HuyNguyen-01/Power-Management/Connector Extension Board V1.0/Connector_Extension_Board_V1.0/Connector_Extension_Board_V1.0.step

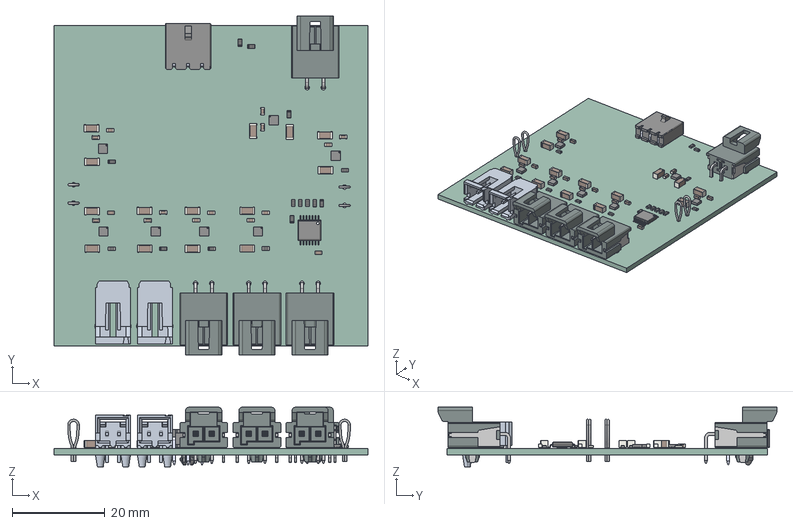
[picture p1: CAD file, 2026-01-13]
Connector Extension Board V1.0/Connector_Extension_Board_V1.0/Connector_Extension_Board_V1.0.step
67.7 x 73.0 x 12.8 mm
TestPoint_Loop_D2.50mm_Drill1.0mm x 4
TPS259571DSGR x 7
R_0603_1608Metric x 15
C_0603_1608Metric x 15
C_1206_3216Metric x 14
TPS1HC30BQPWPRQ1
Connector_Extension_Board_V1.0_PCB
