HuyNguyen-01/Power-Management/Power management V2/Power_management_V2/Power_management_V2.step

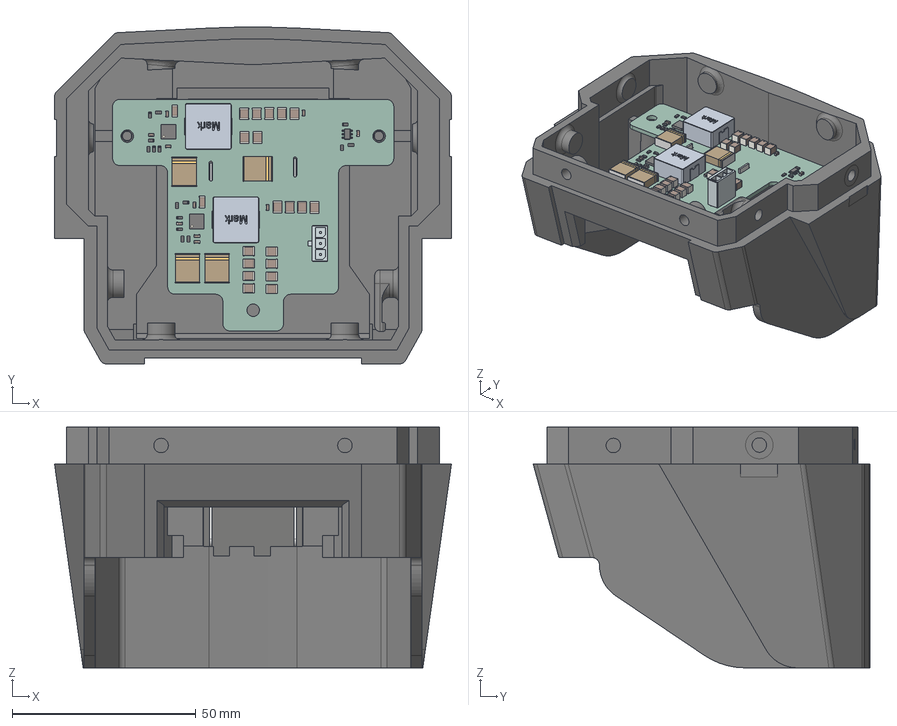
[picture p2: CAD file, 2026-01-13]
Power management V2/Power_management_V2/Power_management_V2.step
108.0 x 91.6 x 65.5 mm
C_0603_1608Metric x 10
R_0603_1608Metric x 15
C_1210_3225Metric x 19
C_1206_3216Metric x 2
SRP1265A series x 2
CAP_C7563_TDK x 4
WSON-14-1EP_4.0x4.0mm_P0.5mm_EP2.6x2.6mm x 2
TSOT-23-6
DIP-PUL-3005-1
DIP-PUL-3010-1 v1
Power_management_V2_PCB
