HuyNguyen-01/Power-Management/Power management V2/Power_management_V2/3D/Batterry.step

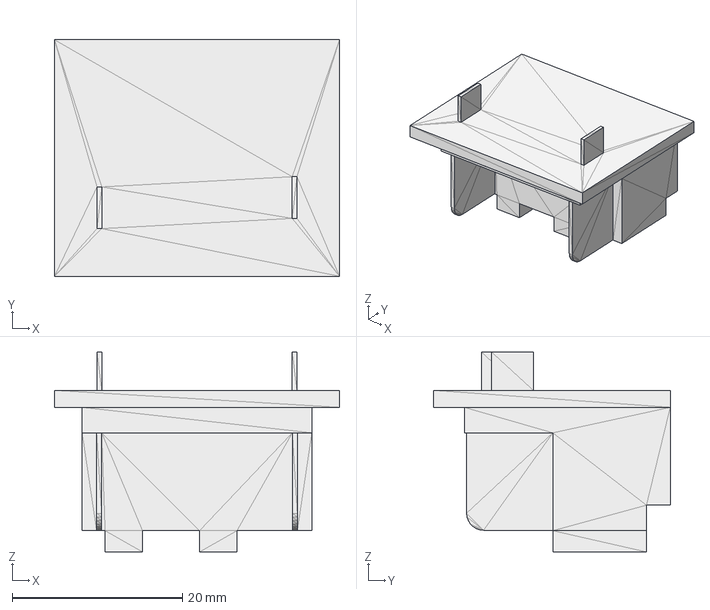
[picture p3: CAD file, 2025-12-29]
Power management V2/Power_management_V2/3D/Batterry.step
33.5 x 27.8 x 23.5 mm
