HuyNguyen-01/Power-Management/Power management V2/Power_management_V2/3D/DIP-PUL-3005-2.step

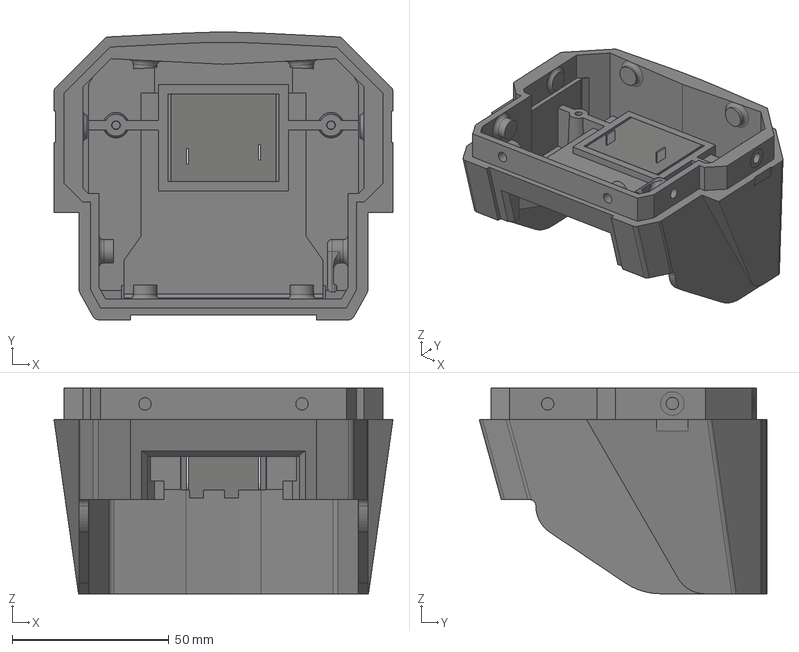
[picture p4: CAD file, 2025-12-29]
Power management V2/Power_management_V2/3D/DIP-PUL-3005-2.step
108.0 x 91.6 x 65.5 mm
DIP-PUL-3005-1
DIP-PUL-3010-1
