HuyNguyen-01/Power-Management/Connector Extension Board V1.0/Connector_Extension_Board_V1.0/3D/5-104361-1.step

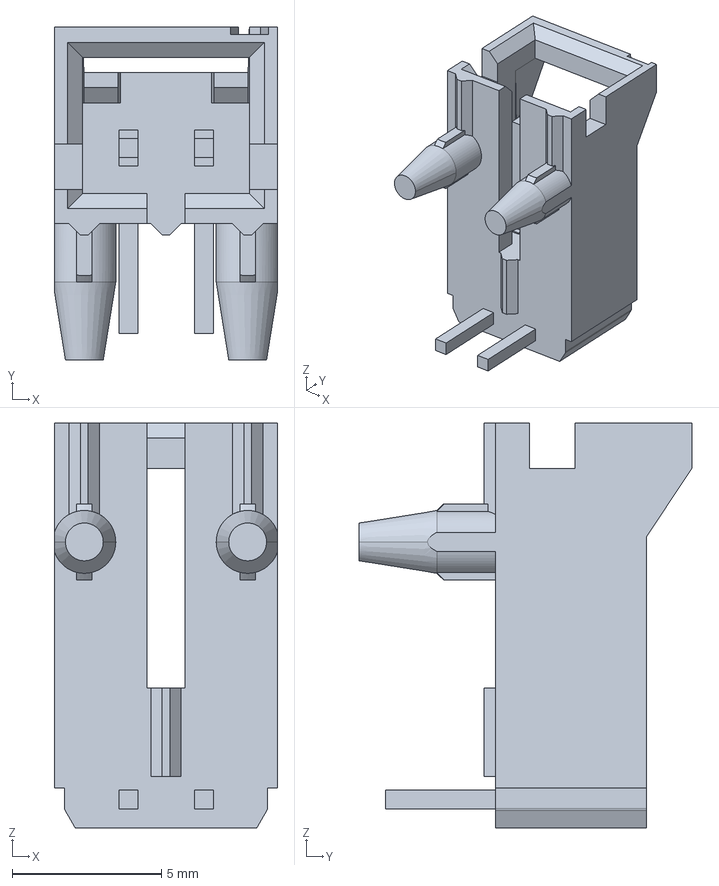
[picture p5: CAD file, 2025-12-26]
Connector Extension Board V1.0/Connector_Extension_Board_V1.0/3D/5-104361-1.step
7.49 x 11.2 x 13.6 mm
