HuyNguyen-01/Power-Management/Power management V2/Power_management_V2/3D/CAP_C7563_TDK.step

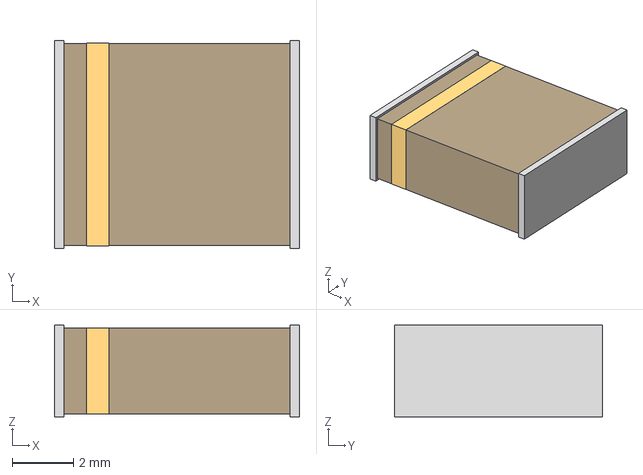
[picture p6: CAD file, 2025-12-29]
Power management V2/Power_management_V2/3D/CAP_C7563_TDK.step
8.00 x 6.81 x 3.00 mm
