HuyNguyen-01/Power-Management/Connector Extension Board V1.0/Connector_Extension_Board_V1.0/3D/TPS1HC30BQPWPRQ1.step

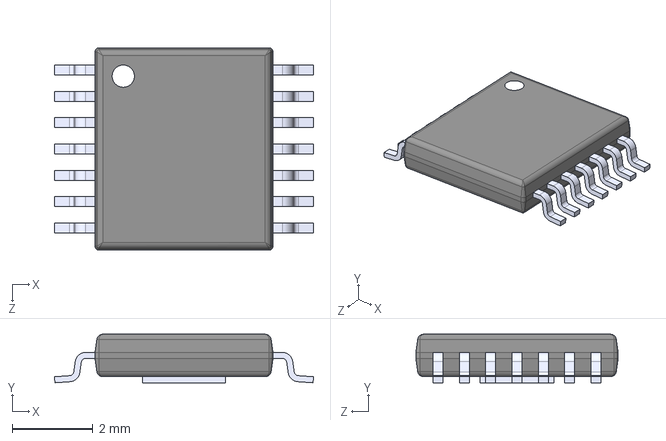
[picture p7: CAD file, 2025-12-26]
Connector Extension Board V1.0/Connector_Extension_Board_V1.0/3D/TPS1HC30BQPWPRQ1.step
6.40 x 1.20 x 5.00 mm
