HuyNguyen-01/Power-Management/Power management V2/Power_management_V2/3D/M18 Battery Terminal.step

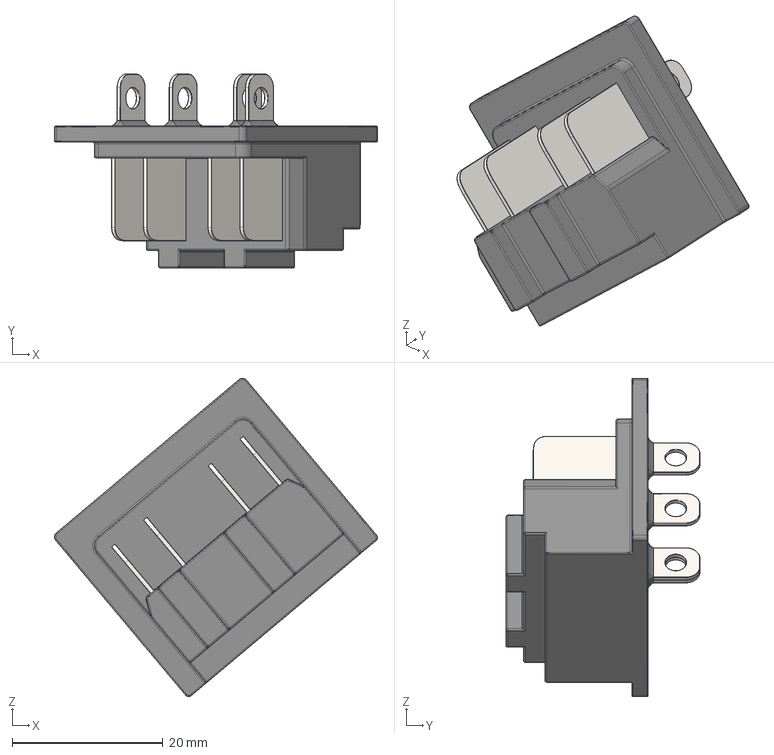
[picture p8: CAD file, 2025-12-26]
Power management V2/Power_management_V2/3D/M18 Battery Terminal.step
42.8 x 25.7 x 42.2 mm
