HuyNguyen-01/Power-Management/Power management V2/Power_management_V2/3D/SRP1265A series.stp

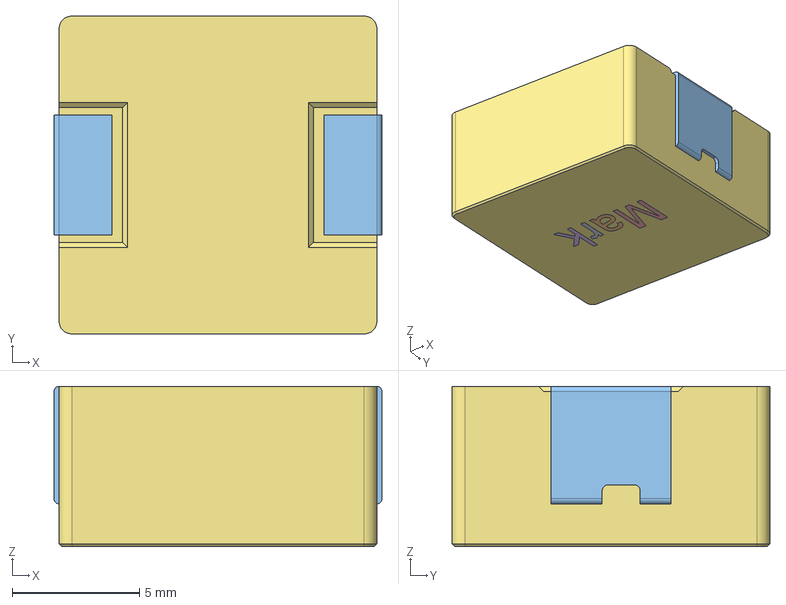
[picture p9: CAD file, 2025-12-26]
Power management V2/Power_management_V2/3D/SRP1265A series.stp
12.9 x 12.5 x 6.30 mm
