HuyNguyen-01/Power-Management/Connector Extension Board V1.0/Connector_Extension_Board_V1.0/3D/5-104809-1.step

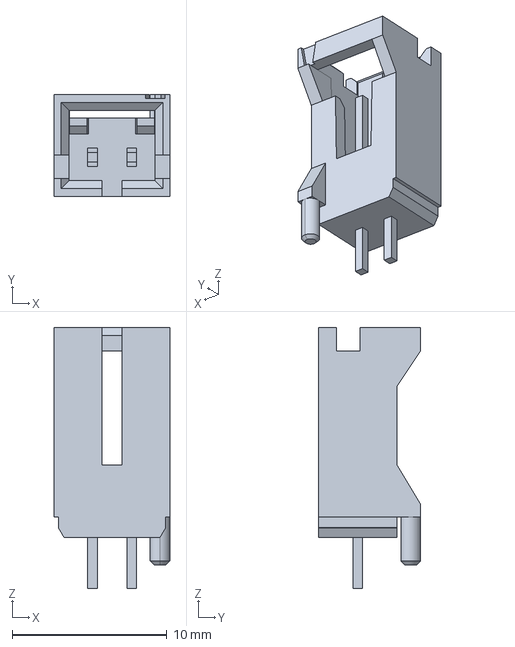
[picture p10: CAD file, 2025-12-17]
Connector Extension Board V1.0/Connector_Extension_Board_V1.0/3D/5-104809-1.step
7.49 x 6.60 x 16.9 mm
