HuyNguyen-01/Power-Management/Connector Extension Board V1.0/Connector_Extension_Board_V1.0/3D/1723103104.step

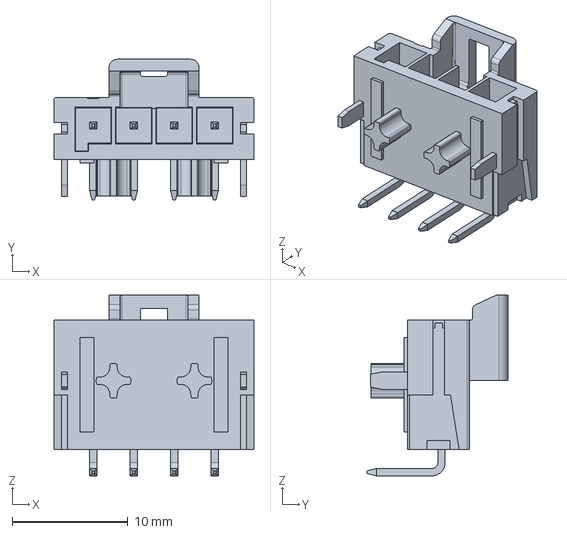
[picture p11: CAD file, 2026-02-25]
Connector Extension Board V1.0/Connector_Extension_Board_V1.0/3D/1723103104.step
17.3 x 12.2 x 15.6 mm
