HuyNguyen-01/Power-Management/Power management V2/Power_management_V2/3D/1722861104.step

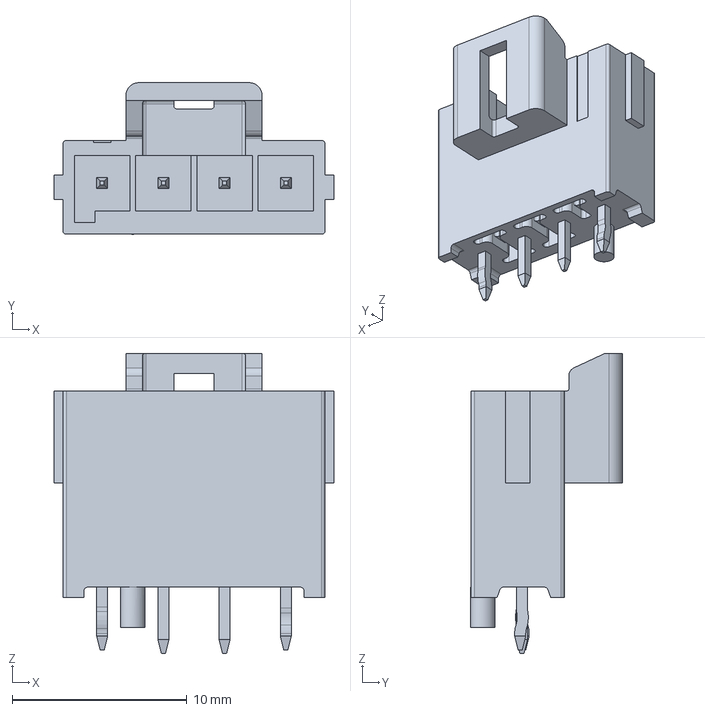
[picture p12: CAD file, 2026-02-25]
Power management V2/Power_management_V2/3D/1722861104.step
16.0 x 8.67 x 17.2 mm
