HuyNguyen-01/Power-Management/Connector Extension Board V1.0/Connector_Extension_Board_V1.0/3D/2157601004.step

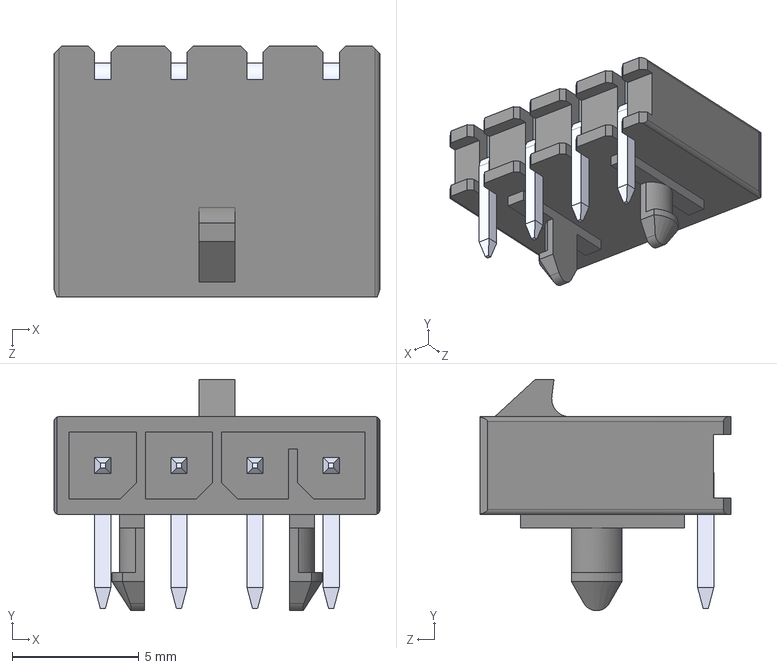
[picture p13: CAD file, 2026-02-04]
Connector Extension Board V1.0/Connector_Extension_Board_V1.0/3D/2157601004.step
12.9 x 9.12 x 9.90 mm
