HuyNguyen-01/Power-Management/Power management V2/Power_management_V2/3D/2165711004.stp

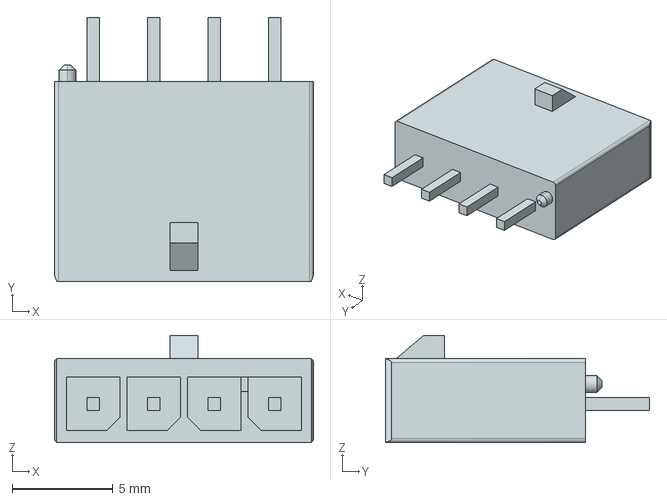
[picture p14: CAD file, 2026-02-04]
Power management V2/Power_management_V2/3D/2165711004.stp
12.8 x 13.1 x 5.33 mm
