HuyNguyen-01/Power-Management/Connector Extension Board V1.0/Connector_Extension_Board_V1.0/3D/TPS259571DSGR.step

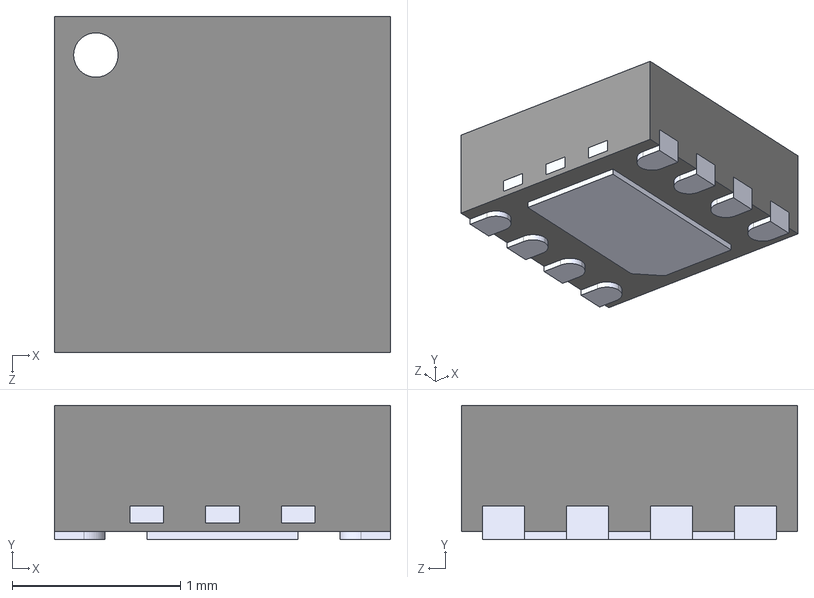
[picture p15: CAD file, 2026-01-13]
Connector Extension Board V1.0/Connector_Extension_Board_V1.0/3D/TPS259571DSGR.step
2.00 x 0.8 x 2.00 mm
