HuyNguyen-01/Power-Management/Power management V2/Power_management_V2/3D/2165711003.stp

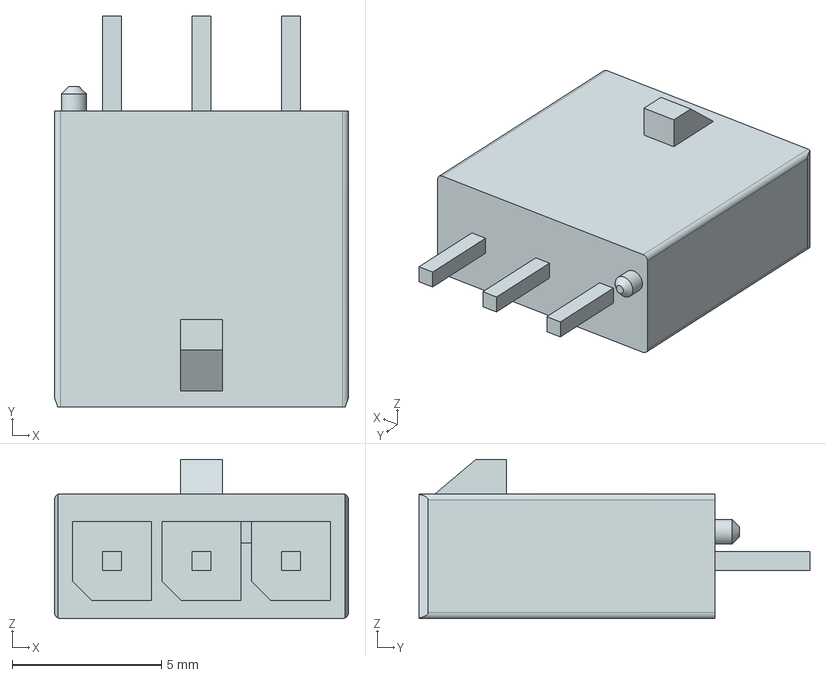
[picture p16: CAD file, 2026-01-12]
Power management V2/Power_management_V2/3D/2165711003.stp
9.85 x 13.1 x 5.33 mm
