HuyNguyen-01/Power-Management/Connector Extension Board V1.0/Connector_Extension_Board_V1.0/3D/2157601003.step

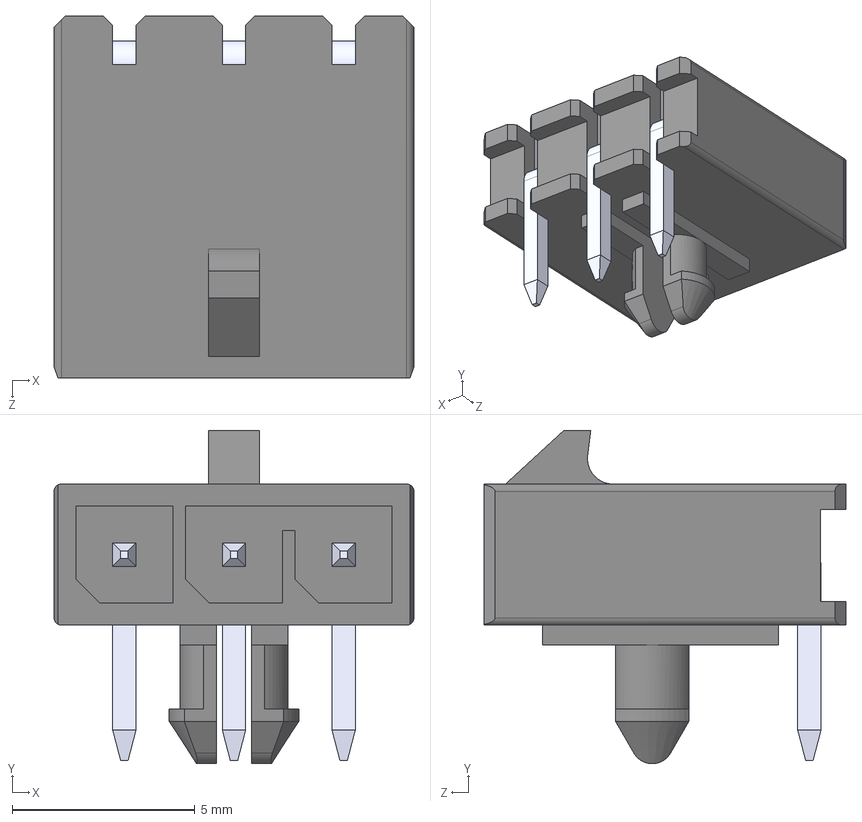
[picture p17: CAD file, 2026-01-13]
Connector Extension Board V1.0/Connector_Extension_Board_V1.0/3D/2157601003.step
9.85 x 9.12 x 9.90 mm
