HuyNguyen-01/Power-Management/(list of files, cad)

Other CAD files:
Connector Extension Board V1.0/Connector_Extension_Board_V1.0/3D/1722871102.step
Connector Extension Board V1.0/Connector_Extension_Board_V1.0/3D/1723103102.stp
Connector Extension Board V1.0/Connector_Extension_Board_V1.0/3D/640388-3.STEP
Power management V2/Power_management_V2/3D/1722871102.step
Power management V2/Power_management_V2/3D/640388-3.STEP
