HuyNguyen-01/Power-Management/Connector Extension Board V1.0/Connector_Extension_Board_V1.0/Connector_Extension_Board_V1.0_SCH_0113.pdf

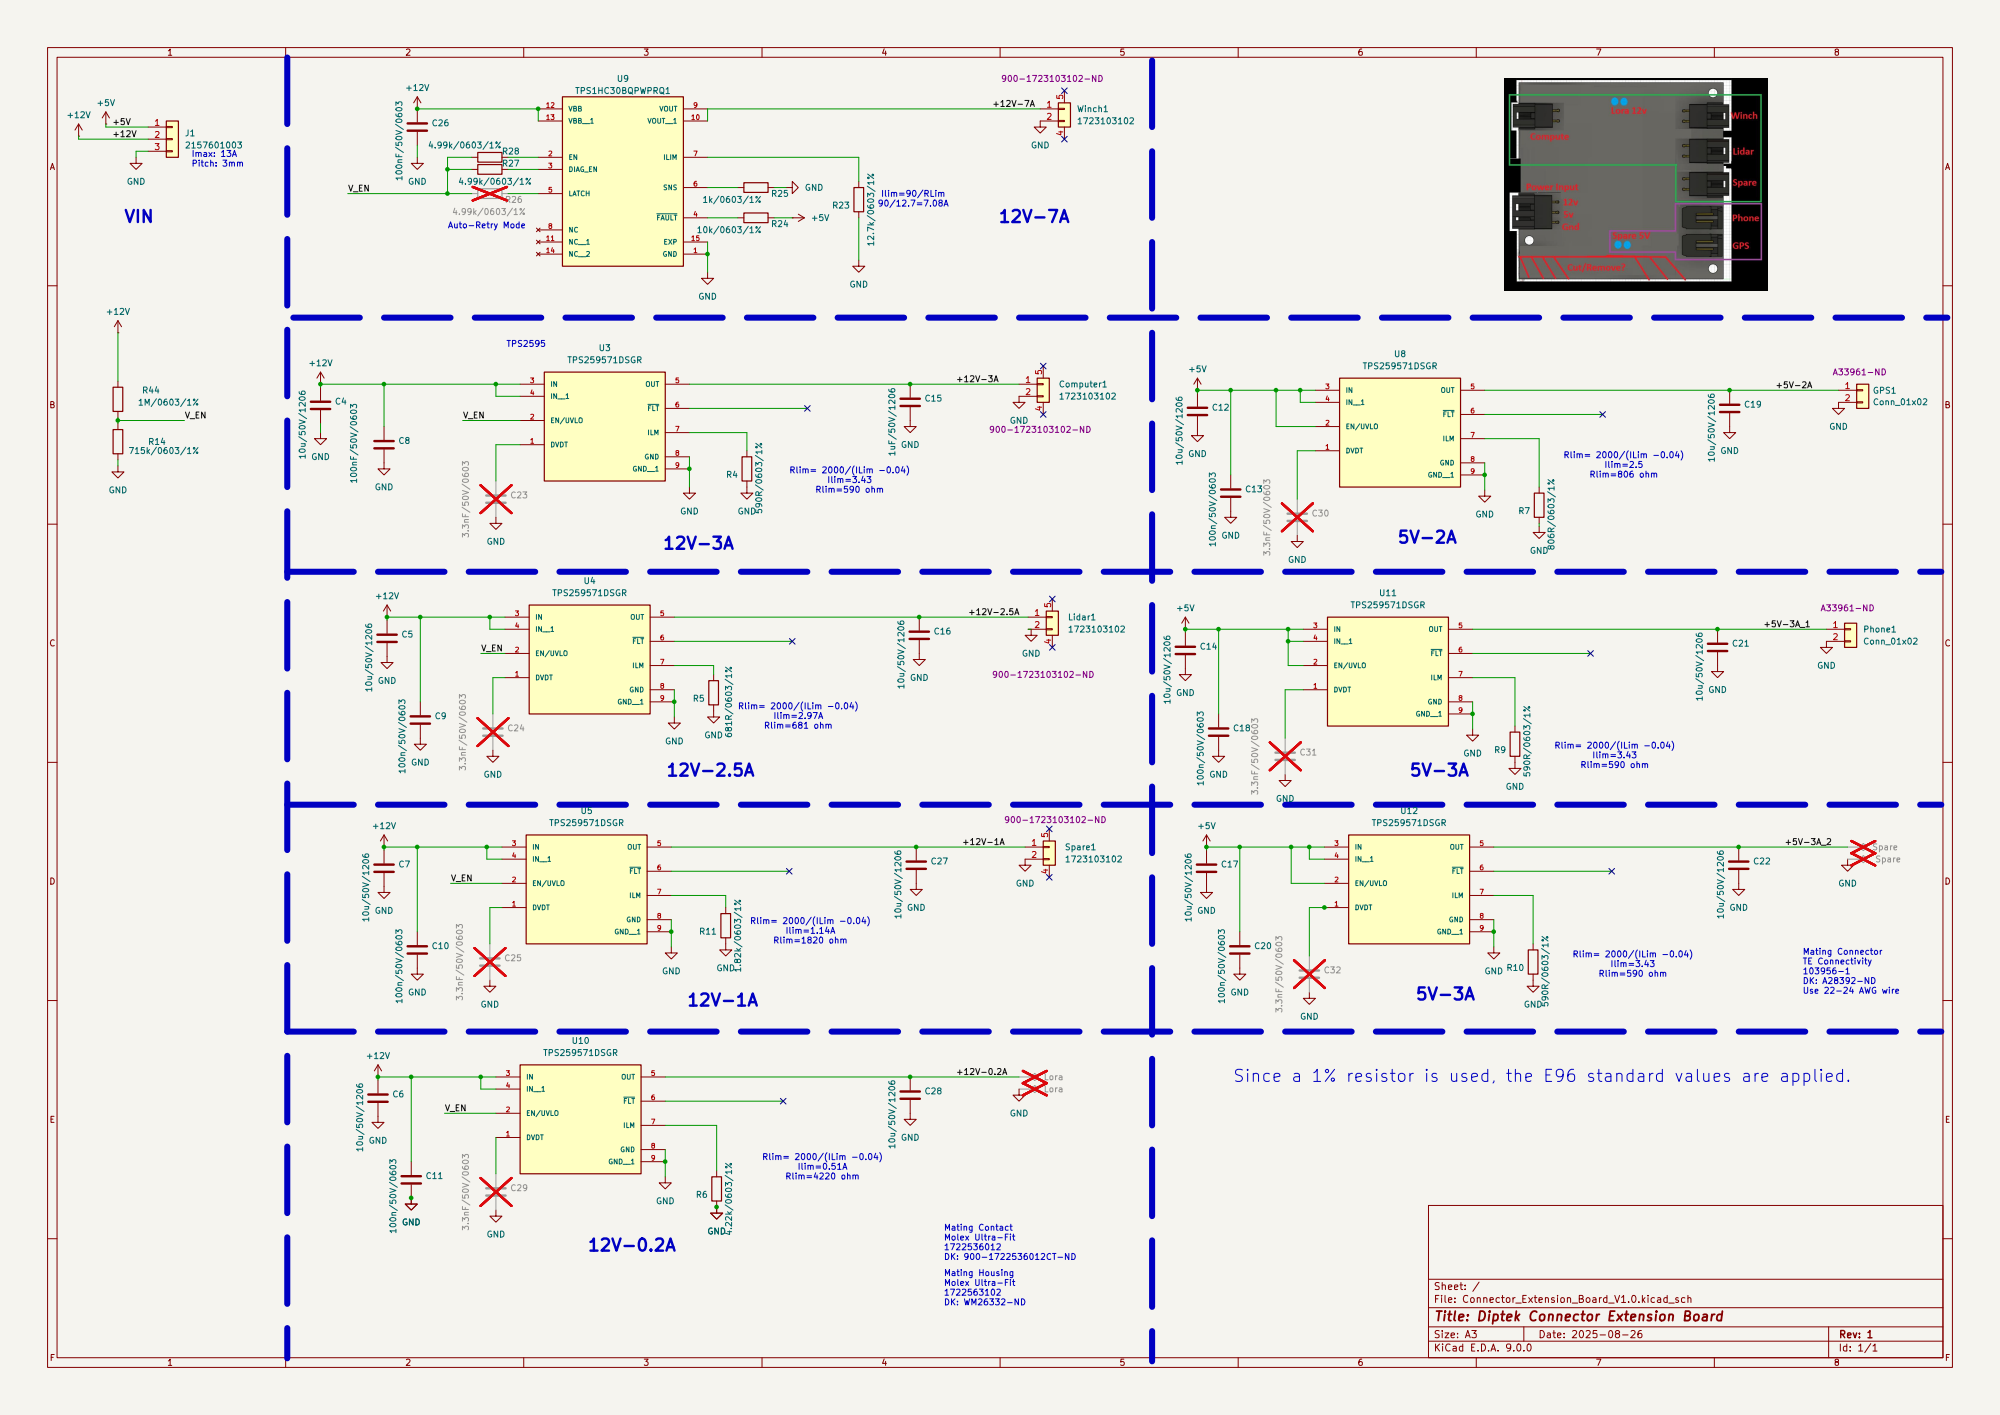
[picture p18: page 1]
