HuyNguyen-01/Power-Management/Power management V2/Power_management_V2/Power_management_V2_0113.pdf

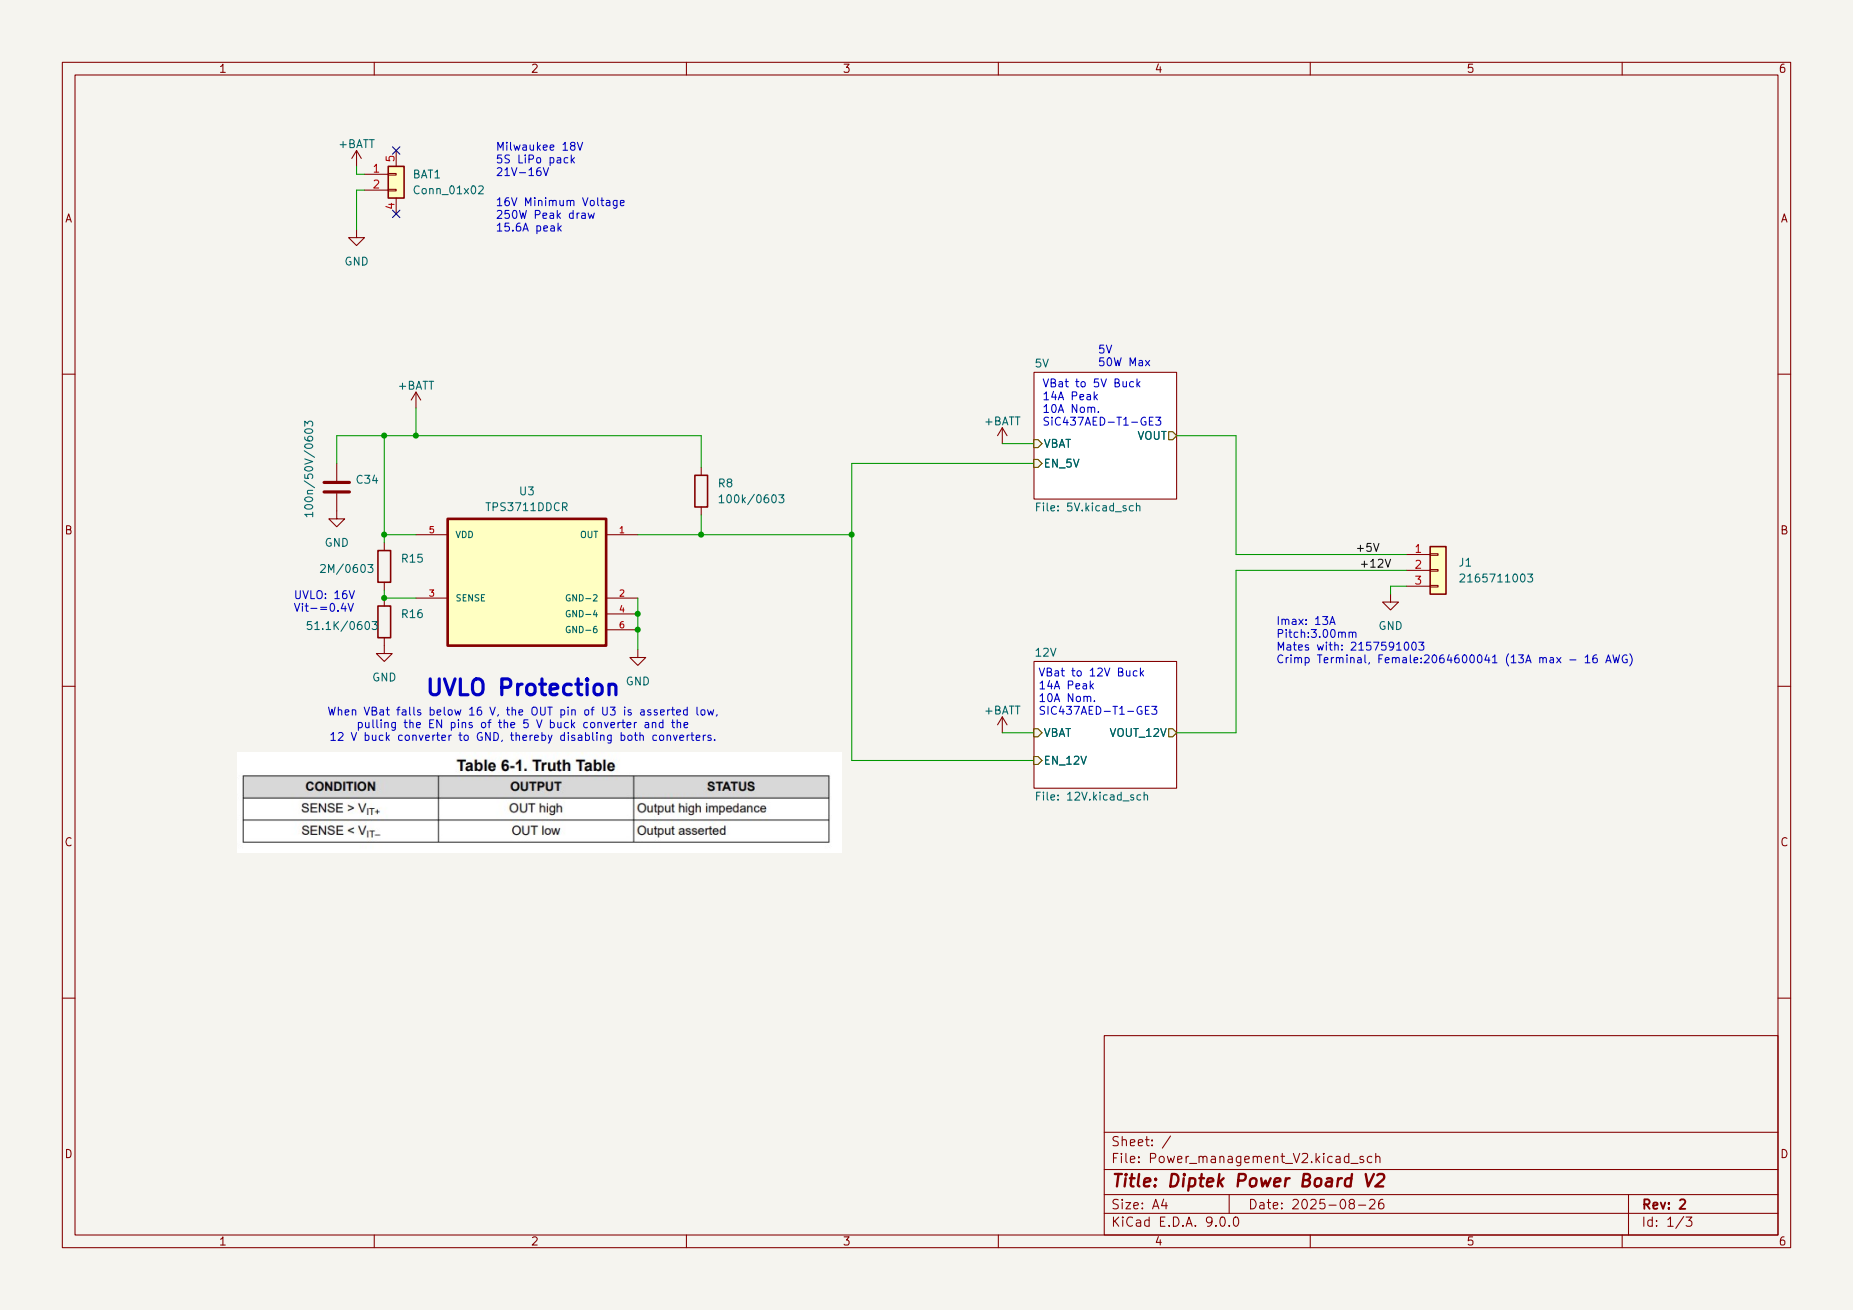
[picture p19: page 1]

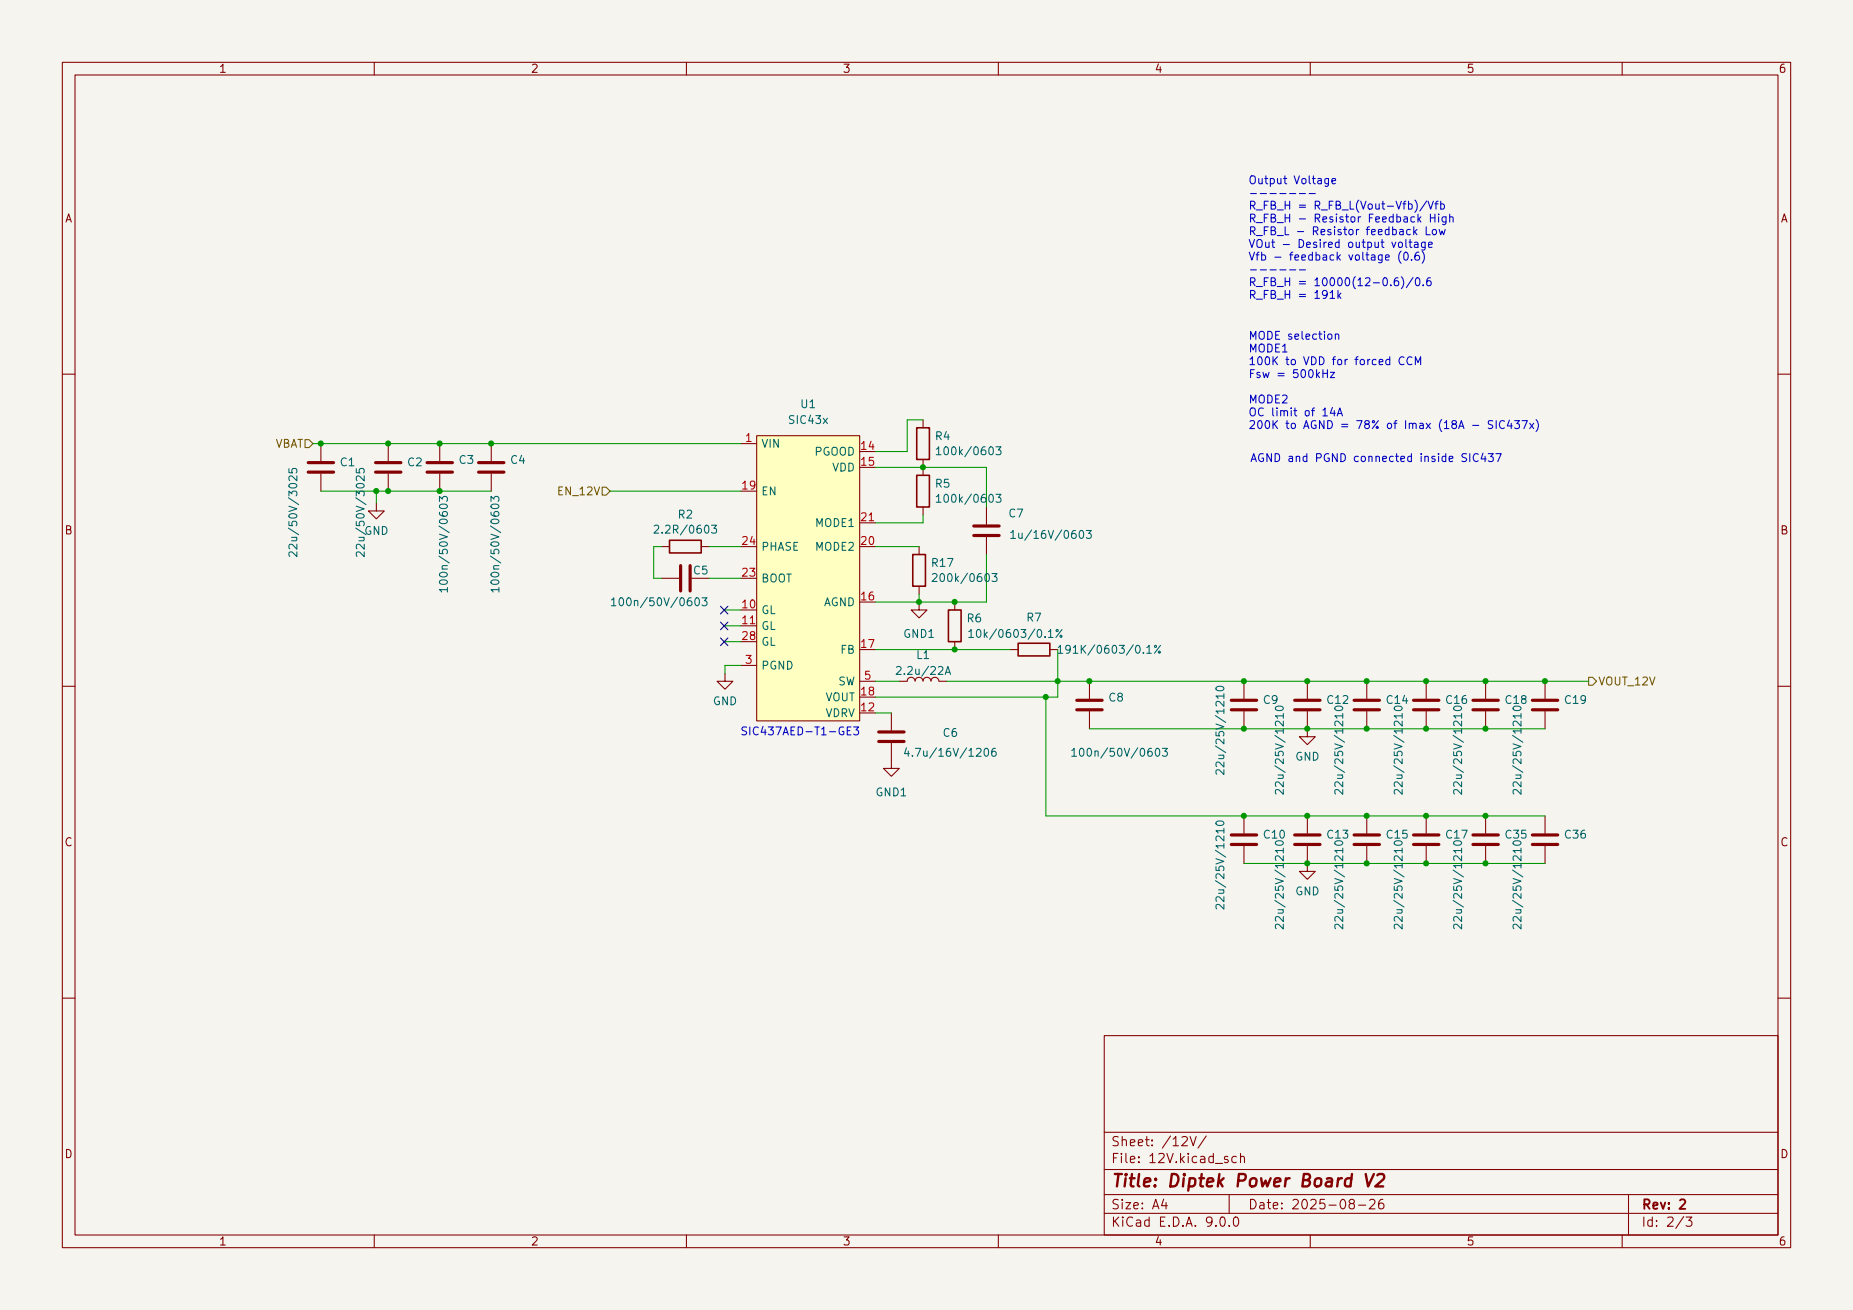
[picture p20: page 2]

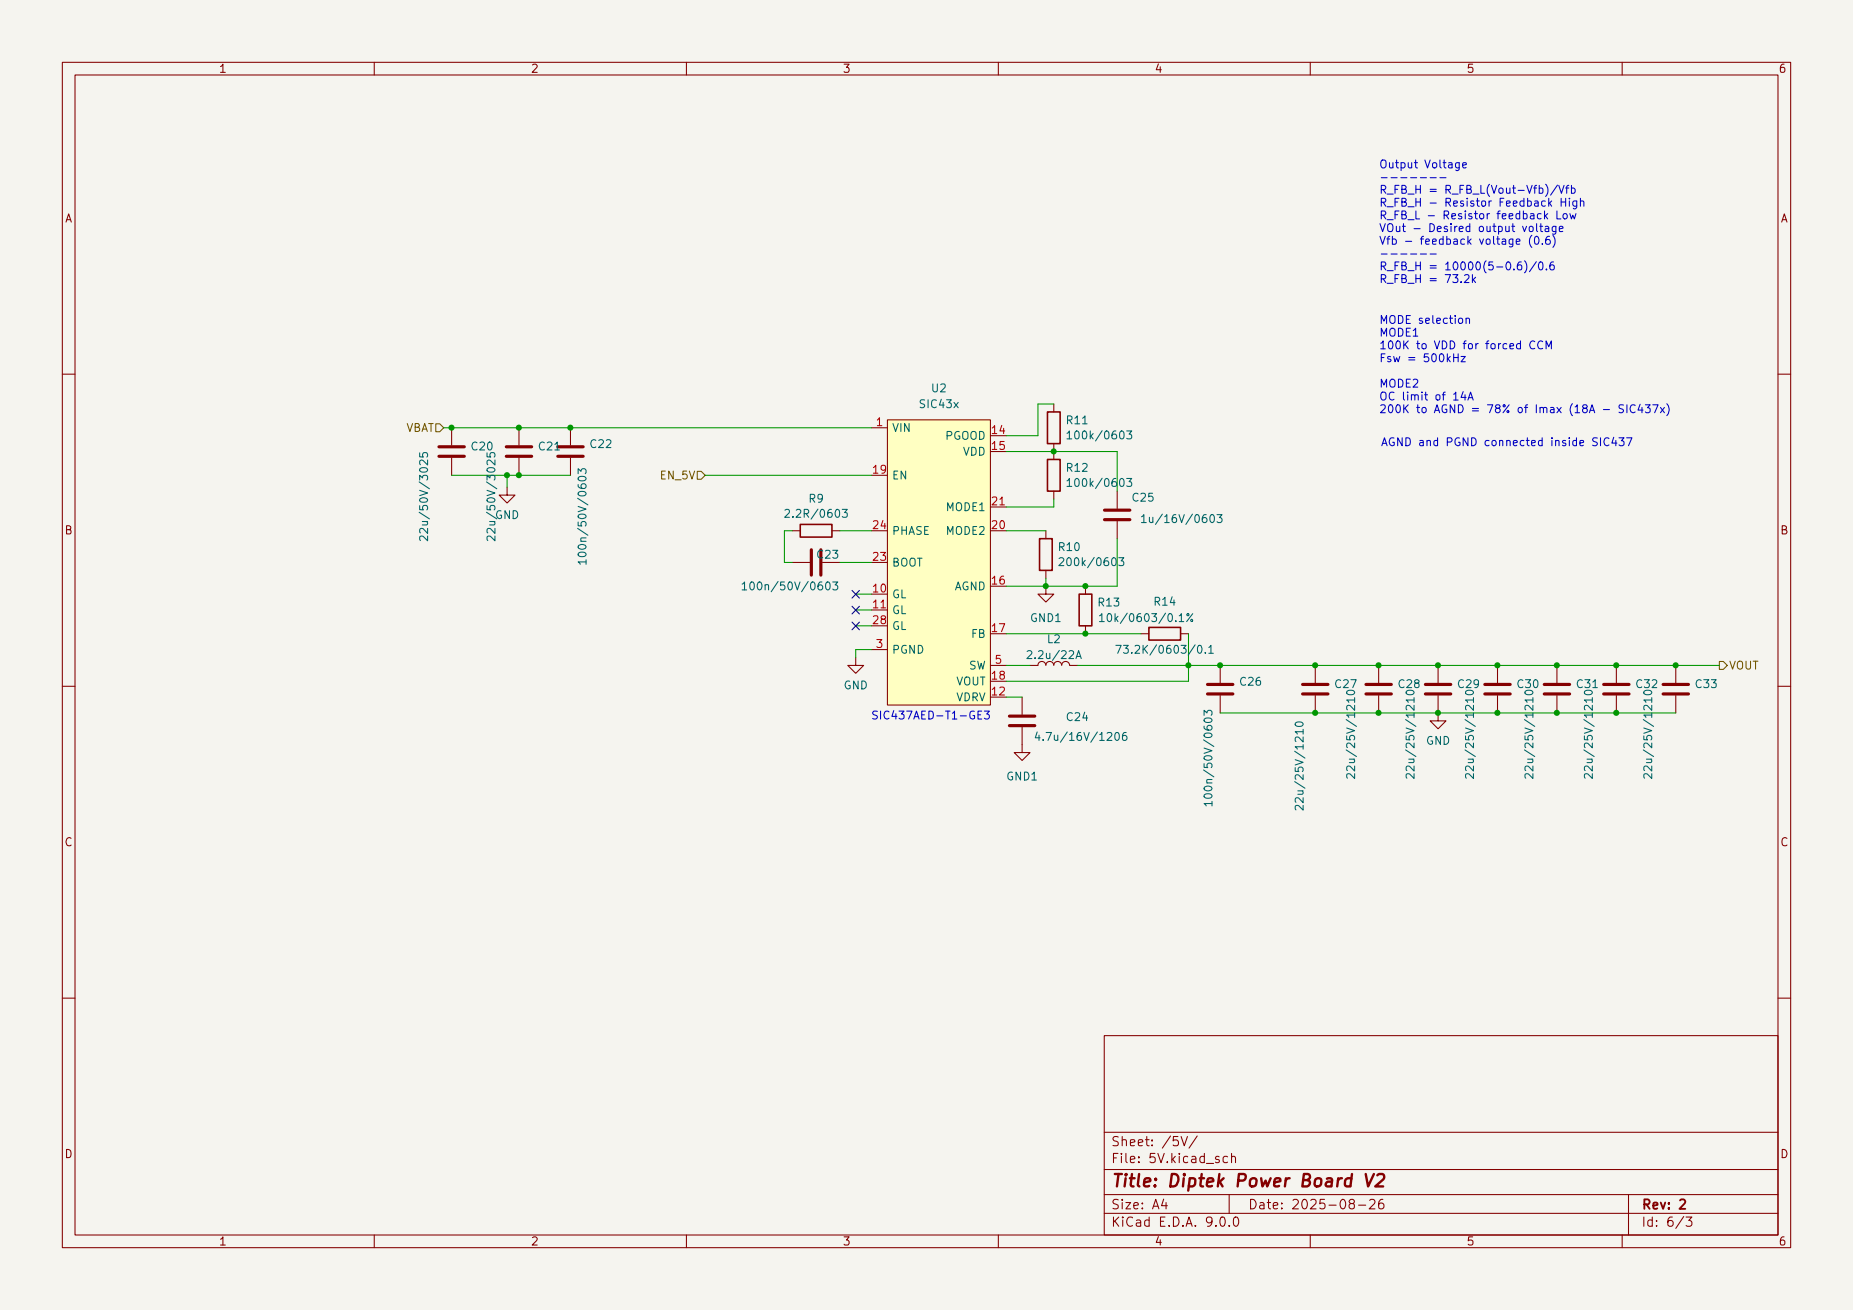
[picture p21: page 3]
