HuyNguyen-01/Power-Management/Power management V2/Power_management_V2/Power_management_V2.kicad_pcb

## KiCad design Power management V2/Power_management_V2/Power_management_V2.kicad_pcb (2026-02-26)

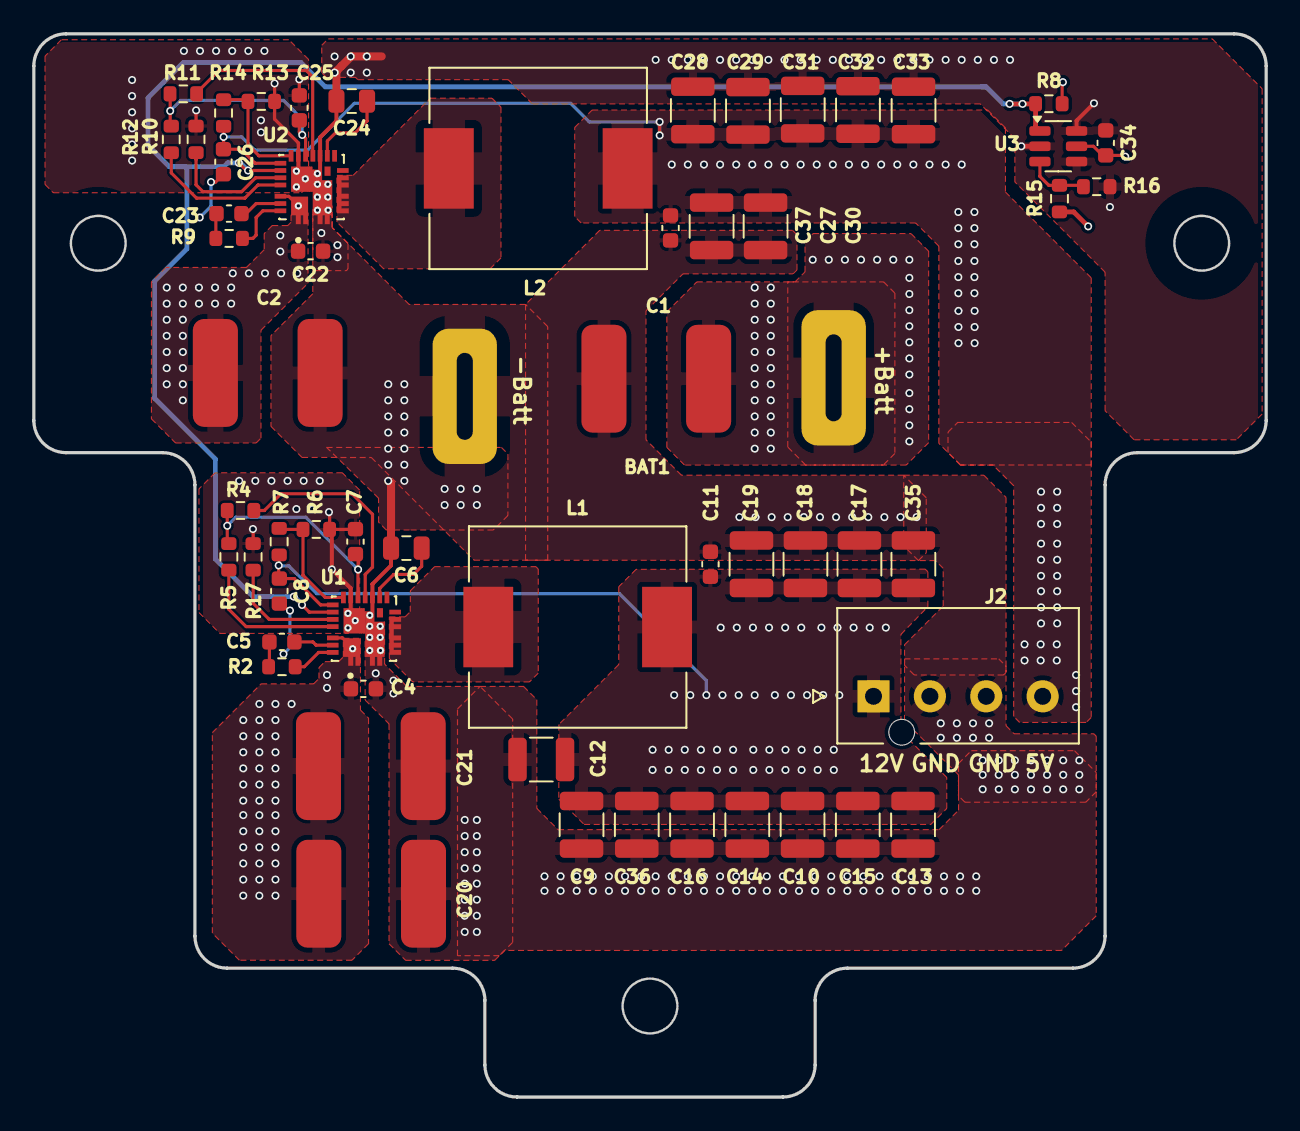
[picture p22: board Power_management_V2.kicad_pcb from above]

Board: 4 copper layers, 76.5 x 66.0 mm, 60 parts (0 on the bottom side), 28 nets.

Parts:
BAT1: Conn_01x02; Milwaukee 18V battery connector R1
C1, C2, C20, C21: 22u/50V/3025; C_CER_7.5x6.3
C4, C5, C8, C11, C22, C23, C26, C34, C37: 100n/50V/0603; C_0603_1608Metric
C6, C24: 4.7u/50V/0805; C_0805_2012Metric
C7, C25: 1u/50V/0603; C_0603_1608Metric
C9, C10, C12, C13, C14, C15, C16, C17, C18, C19, C27, C28, C29, C30, C31, C32, C33, C35, C36: 22u/25V/1210; C_1210_3225Metric
J2: 1722861104; MOLEX_1722861104
L1, L2: 2.2u/22A; IND_SRP1265A-2R2M
NT1, NT2: NetTie_2; NetTie-2_SMD_Pad1.56mm
R2, R9: 2.2R/0603; R_0603_1608Metric
R4, R5, R8, R11, R12: 100k/0603; R_0603_1608Metric
R6, R13: 10k/0603/0.1%; R_0603_1608Metric
R7: 191K/0603/0.1%; R_0603_1608Metric
R10, R17: 200k/0603; R_0603_1608Metric
R14: 73.2K/0603/0.1; R_0603_1608Metric
R15: 2M/0603; R_0603_1608Metric
R16: 51.1K/0603; R_0603_1608Metric
U1, U2: SIC437AED; VREG_SIC437AED-T1-GE3
U3: TPS3711DDCR; TSOT-23-6

Connections:
+BATT: BAT1.1, C1.1, C2.1, C4.2, C20.1, C21.1, C22.2, C34.2, R8.2, R15.2, U1.1 (VIN), U1.22 (VIN), U2.1 (VIN), U2.22 (VIN), U3.5 (VDD)
/12V/EN_12V: R8.1, U1.19 (EN), U2.19 (EN), U3.1 (OUT)
/+5V: C26.2, C27.1, C28.1, C29.1, C30.1, C31.1, C32.1, C33.1, C37.2, J2.4, L2.2, R14.2, U2.18 (VOUT)
/+12V: C8.2, C9.1, C10.1, C11.2, C12.1, C13.1, C14.1, C15.1, C16.1, C17.1, C18.1, C19.1, C35.1, C36.1, J2.1, L1.2, R7.2, U1.18 (VOUT)
GND: BAT1.2, C1.2, C2.2, C4.1, C6.2, C8.1, C9.2, C10.2, C11.1, C12.2, C13.2, C14.2, C15.2, C16.2, C17.2, C18.2, C19.2, C20.2, C21.2, C22.1, C24.2, C26.1, C27.2, C28.2, C29.2, C30.2, C31.2, C32.2, C33.2, C34.1, C35.2, C36.2, C37.1, J2.2, J2.3, NT1.2, NT2.2, R16.1, U1.3 (PGND), U1.13 (PGND), U2.3 (PGND), U2.13 (PGND), U3.2 (GND-2), U3.4 (GND-4), U3.6 (GND-6)
GND1: C25.2, NT1.1, R10.2, R13.1, U2.16 (AGND), U2.25 (AGND)
GND2: C7.2, NT2.1, R6.1, R17.2, U1.16 (AGND), U1.25 (AGND)
unnamed: C5.2, R2.2
unnamed: C23.2, R9.2
unnamed: L1.1, U1.5 (SW)
unnamed: L2.1, U2.5 (SW)
unnamed: C5.1, U1.23 (BOOT)
unnamed: R6.2, R7.1, U1.17 (FB)
unnamed: R5.2, U1.21 (MODE1)
unnamed: R17.1, U1.20 (MODE2)
unnamed: R4.1, U1.14 (PGOOD)
unnamed: R2.1, U1.24 (PHASE)
unnamed: C7.1, R4.2, R5.1, U1.15 (VDD)
unnamed: C6.1, U1.12 (VDRV)
unnamed: C23.1, U2.23 (BOOT)
unnamed: R13.2, R14.1, U2.17 (FB)
unnamed: R12.2, U2.21 (MODE1)
unnamed: R10.1, U2.20 (MODE2)
unnamed: R11.1, U2.14 (PGOOD)
unnamed: R9.1, U2.24 (PHASE)
unnamed: C25.1, R11.2, R12.1, U2.15 (VDD)
unnamed: C24.1, U2.12 (VDRV)
unnamed: R15.1, R16.2, U3.3 (SENSE)
