HuyNguyen-01/Power-Management/Connector Extension Board V1.0/Connector_Extension_Board_V1.0/Connector_Extension_Board_V1.0.kicad_pcb

## KiCad design Connector Extension Board V1.0/Connector_Extension_Board_V1.0/Connector_Extension_Board_V1.0.kicad_pcb (2026-02-26)

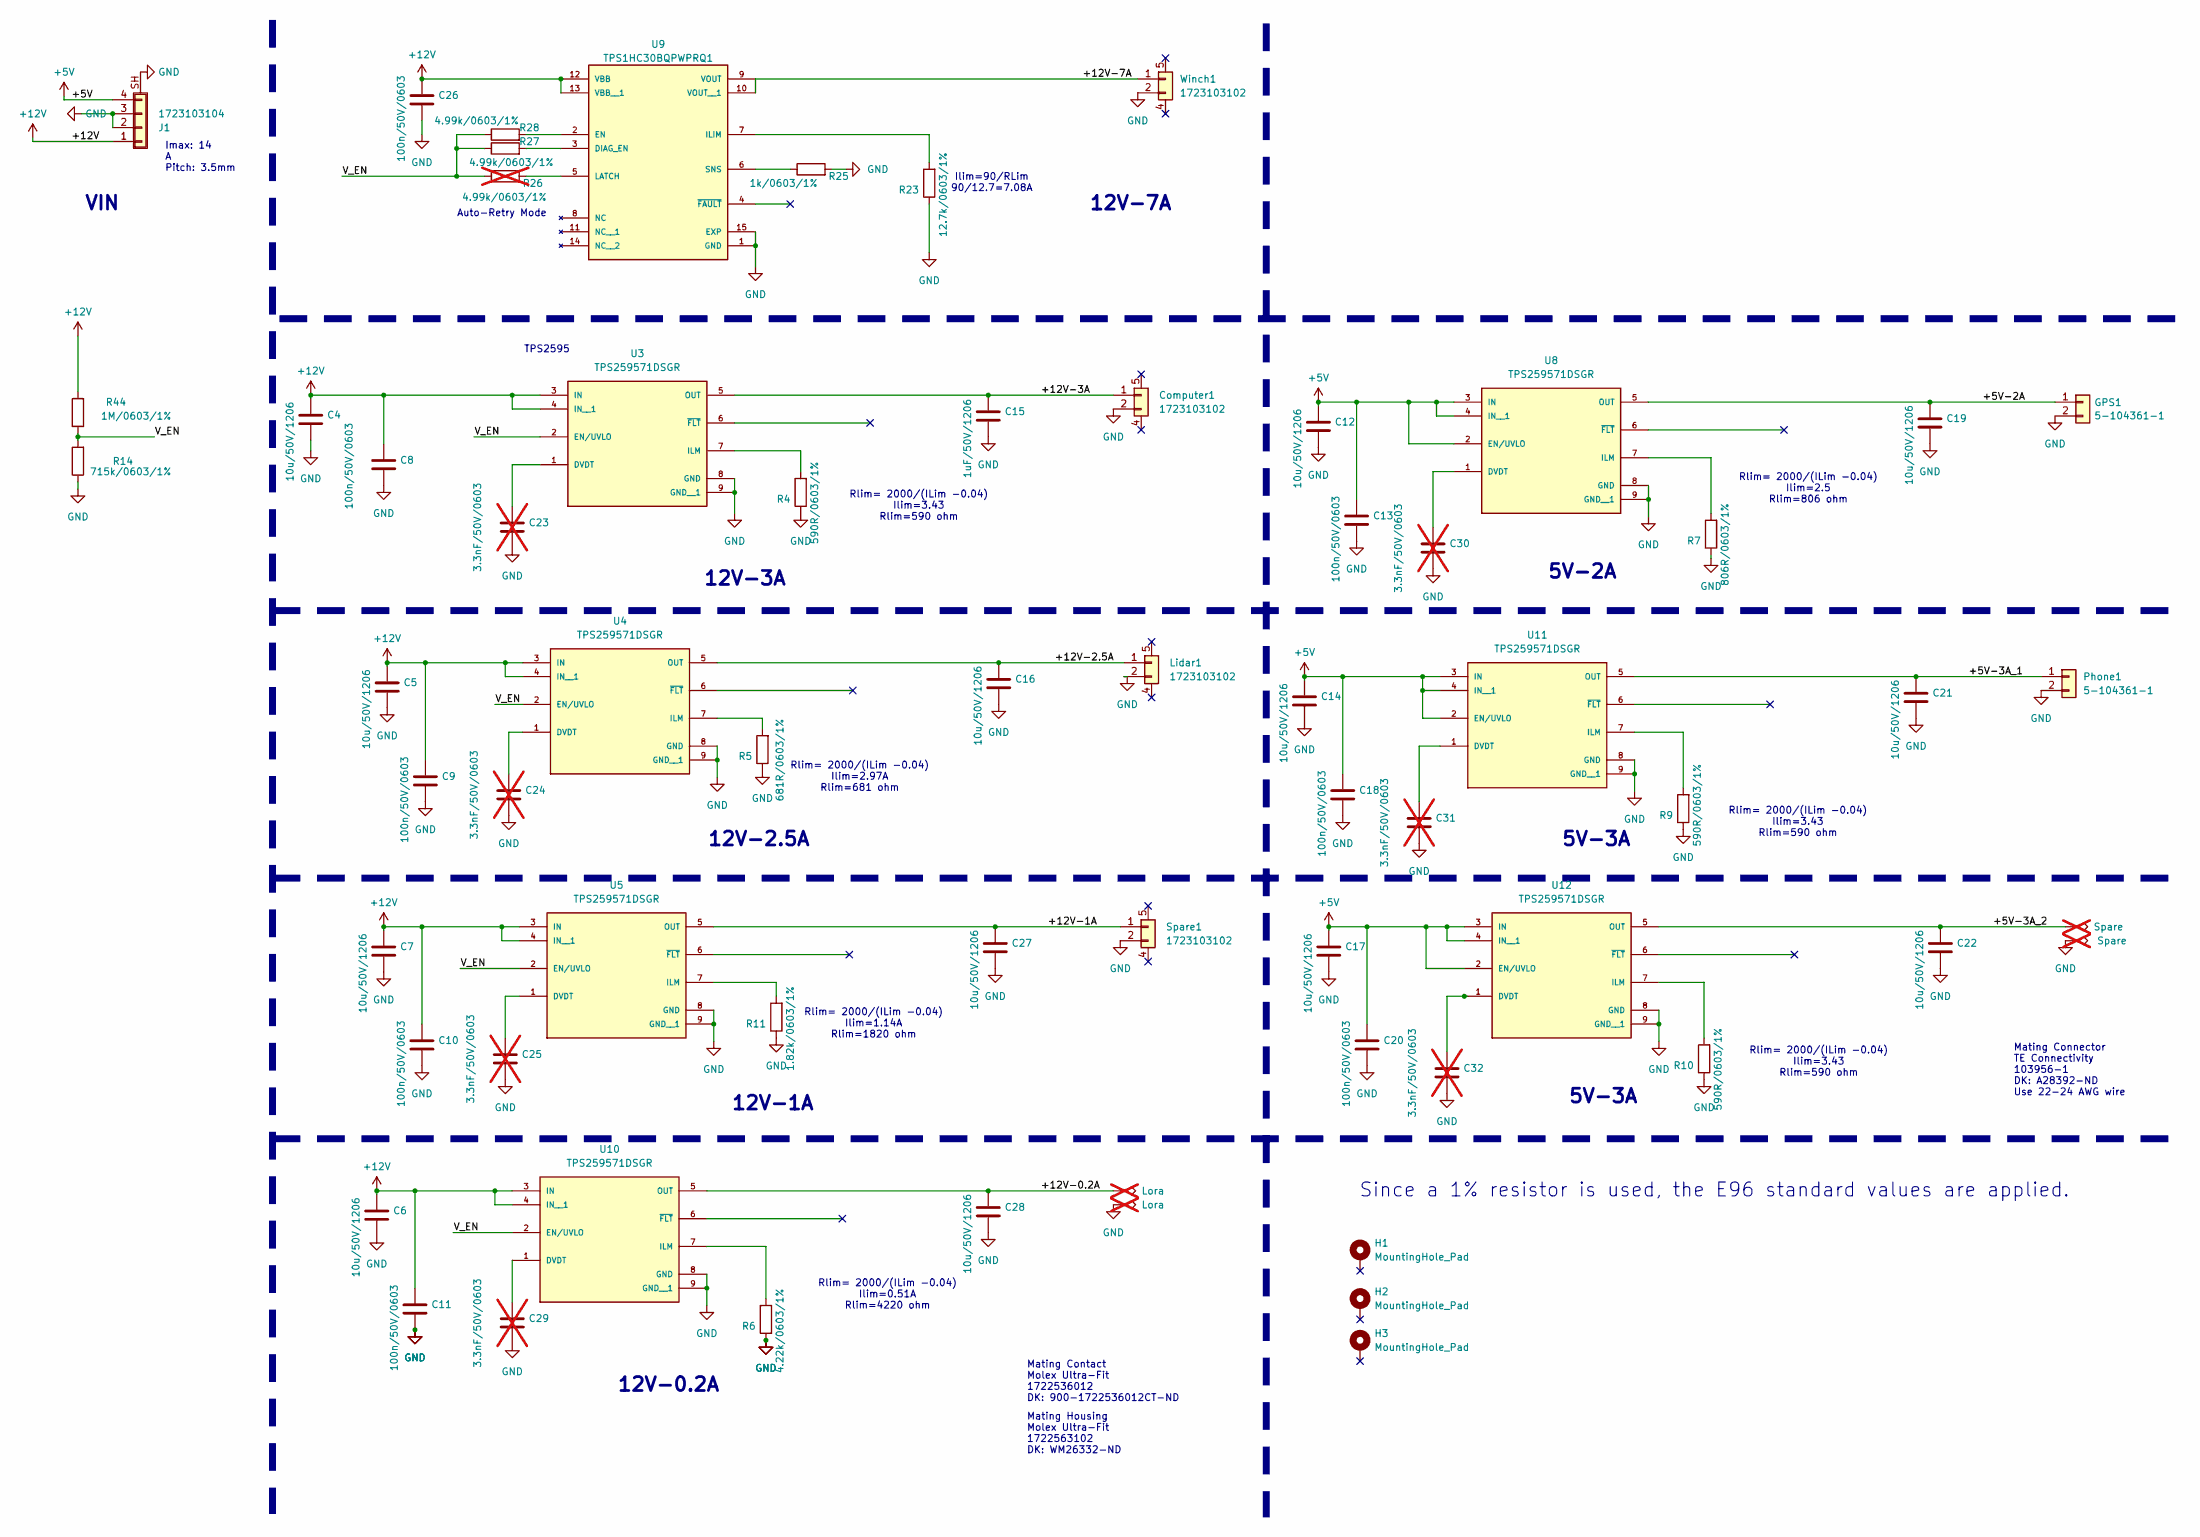
[picture p23: schematic Connector_Extension_Board_V1.0.kicad_sch, Diptek Connector Extension Board]

Parts:
C4, C5, C6, C7, C12, C14, C16, C17, C19, C21, C22, C27, C28: 10u/50V/1206; C_1206_3216Metric; Digikey 1276-2876-1-ND
C8, C9, C10, C11, C13, C18, C20, C26: 100n/50V/0603; C_0603_1608Metric; Digikey 587-1243-1-ND
C15: 1uF/50V/1206; C_1206_3216Metric; Digikey 1276-1068-1-ND
C23, C24, C25, C29, C30, C31, C32: 3.3nF/50V/0603; C_0603_1608Metric; Digikey NC; not fitted
Computer1: 1723103102; MOLEX_1723103102; Part 1723102202; Digikey 900-1723103102-ND
GPS1: 5-104361-1; TE_5-104361-1; Part 5-104361-1; Digikey A33961-ND
H1, H2, H3: MountingHole_Pad; MountingHole_3.1-5.8; Digikey NC
J1: 1723103104; MOLEX_1723103104; DIGIKEY 900-1723103104-ND
Lidar1: 1723103102; MOLEX_1723103102; Part 1723102202; Digikey 900-1723103102-ND
Phone1: 5-104361-1; TE_5-104361-1; Part 5-104361-1; Digikey A33961-ND
R4, R9, R10: 590R/0603/1%; R_0603_1608Metric; Digikey 311-590HRCT-ND
R5: 681R/0603/1%; R_0603_1608Metric; Digikey RMCF0603FT681RCT-ND
R6: 4.22k/0603/1%; R_0603_1608Metric; Digikey 311-4.22KHRCT-ND
R7: 806R/0603/1%; R_0603_1608Metric; Digikey P806HCT-ND
R11: 1.82k/0603/1%; R_0603_1608Metric; Digikey 311-1.82KHRCT-ND
R14: 715k/0603/1%; R_0603_1608Metric; Digikey 311-715KHRCT-ND
R23: 12.7k/0603/1%; R_0603_1608Metric; Digikey P12.7HCT-ND
R25: 1k/0603/1%; R_0603_1608Metric; Digikey RMCF0603FT1K00CT-ND
R26: 4.99k/0603/1%; R_0603_1608Metric; Digikey NC; not fitted
R27, R28: 4.99k/0603/1%; R_0603_1608Metric; Digikey RMCF0603FT4K99CT-ND
R44: 1M/0603/1%; R_0603_1608Metric; Digikey P1.00MHCT-ND
Spare1: 1723103102; MOLEX_1723103102; Part 1723102202; Digikey 900-1723103102-ND
TP1, TP2: Lora; TestPoint_Loop_D2.50mm_Drill1.0mm; not fitted
TP3, TP4: Spare; TestPoint_Loop_D2.50mm_Drill1.0mm; not fitted
U3, U4, U5, U8, U10, U11, U12: TPS259571DSGR; SON50P200X200X80-9N; DIGIKEY 296-50500-1-ND
U9: TPS1HC30BQPWPRQ1; IC_TPS1HC30BQPWPRQ1; DIGIKEY 296-TPS1HC30BQPWPRQ1CT-ND
Winch1: 1723103102; MOLEX_1723103102; Part 1723102202; Digikey 900-1723103102-ND

Connections:
+5V: C12.1, C13.1, C14.1, C17.1, C18.1, C20.1, J1.4, U8.2 (EN/UVLO), U8.3 (IN), U8.4 (IN__1), U11.2 (EN/UVLO), U11.3 (IN), U11.4 (IN__1), U12.2 (EN/UVLO), U12.3 (IN), U12.4 (IN__1)
+12V: C4.1, C5.1, C6.1, C7.1, C8.1, C9.1, C10.1, C11.1, C26.1, J1.1, R44.2, U3.3 (IN), U3.4 (IN__1), U4.3 (IN), U4.4 (IN__1), U5.3 (IN), U5.4 (IN__1), U9.12 (VBB), U9.13 (VBB__1), U10.3 (IN), U10.4 (IN__1)
/+5V-2A: C19.1, GPS1.1, U8.5 (OUT)
/+5V-3A_1: C21.1, Phone1.1, U11.5 (OUT)
/+5V-3A_2: C22.1, TP3.1, U12.5 (OUT)
/+12V-0.2A: C28.1, TP1.1, U10.5 (OUT)
/+12V-1A: C27.1, Spare1.1, U5.5 (OUT)
/+12V-2.5A: C16.1, Lidar1.1, U4.5 (OUT)
/+12V-3A: C15.1, Computer1.1, U3.5 (OUT)
/+12V-7A: U9.9 (VOUT), U9.10 (VOUT__1), Winch1.1
/V_EN: R14.2, R26.1, R27.1, R28.1, R44.1, U3.2 (EN/UVLO), U4.2 (EN/UVLO), U5.2 (EN/UVLO), U10.2 (EN/UVLO)
GND: C4.2, C5.2, C6.2, C7.2, C8.2, C9.2, C10.2, C11.2, C12.2, C13.2, C14.2, C15.2, C16.2, C17.2, C18.2, C19.2, C20.2, C21.2, C22.2, C23.2, C24.2, C25.2, C26.2, C27.2, C28.2, C29.2, C30.2, C31.2, C32.2, Computer1.2, GPS1.2, J1.2, J1.3, J1.SH (Shield), Lidar1.2, Phone1.2, R4.1, R5.1, R6.1, R7.1, R9.1, R10.1, R11.1, R14.1, R23.1, R25.2, Spare1.2, TP2.1, TP4.1, U3.8 (GND), U3.9 (GND__1), U4.8 (GND), U4.9 (GND__1), U5.8 (GND), U5.9 (GND__1), U8.8 (GND), U8.9 (GND__1), U9.1 (GND), U9.15 (EXP), U10.8 (GND), U10.9 (GND__1), U11.8 (GND), U11.9 (GND__1), U12.8 (GND), U12.9 (GND__1), Winch1.2
unnamed: C23.1, U3.1 (DVDT)
unnamed: R4.2, U3.7 (ILM)
unnamed: C24.1, U4.1 (DVDT)
unnamed: R5.2, U4.7 (ILM)
unnamed: C25.1, U5.1 (DVDT)
unnamed: R11.2, U5.7 (ILM)
unnamed: C30.1, U8.1 (DVDT)
unnamed: R7.2, U8.7 (ILM)
unnamed: R27.2, U9.3 (DIAG_EN)
unnamed: R28.2, U9.2 (EN)
unnamed: R23.2, U9.7 (ILIM)
unnamed: R26.2, U9.5 (LATCH)
unnamed: R25.1, U9.6 (SNS)
unnamed: C29.1, U10.1 (DVDT)
unnamed: R6.2, U10.7 (ILM)
unnamed: C31.1, U11.1 (DVDT)
unnamed: R9.2, U11.7 (ILM)
unnamed: C32.1, U12.1 (DVDT)
unnamed: R10.2, U12.7 (ILM)

Notes on the sheet:
5V-3A
12V-3A
Mating Connector TE Connectivity 103956-1 DK: A28392-ND Use 22-24 AWG wire
12V-1A
TPS2595
Rlim= 2000/(ILim -0.04) Ilim=1.14A Rlim=1820 ohm
Mating Housing Molex Ultra-Fit 1722563102 DK: WM26332-ND
12V-7A
Rlim= 2000/(ILim -0.04) Ilim=2.97A Rlim=681 ohm
5V-2A
12V-2.5A
Since a 1% resistor is used, the E96 standard values are applied.
Rlim= 2000/(ILim -0.04) Ilim=2.5 Rlim=806 ohm
Auto-Retry Mode
Imax: 14 A Pitch: 3.5mm
Rlim= 2000/(ILim -0.04) Ilim=3.43 Rlim=590 ohm
Mating Contact Molex Ultra-Fit 1722536012 DK: 900-1722536012CT-ND
VIN
12V-0.2A
Ilim=90/RLim 90/12.7=7.08A
Rlim= 2000/(ILim -0.04) Ilim=0.51A Rlim=4220 ohm

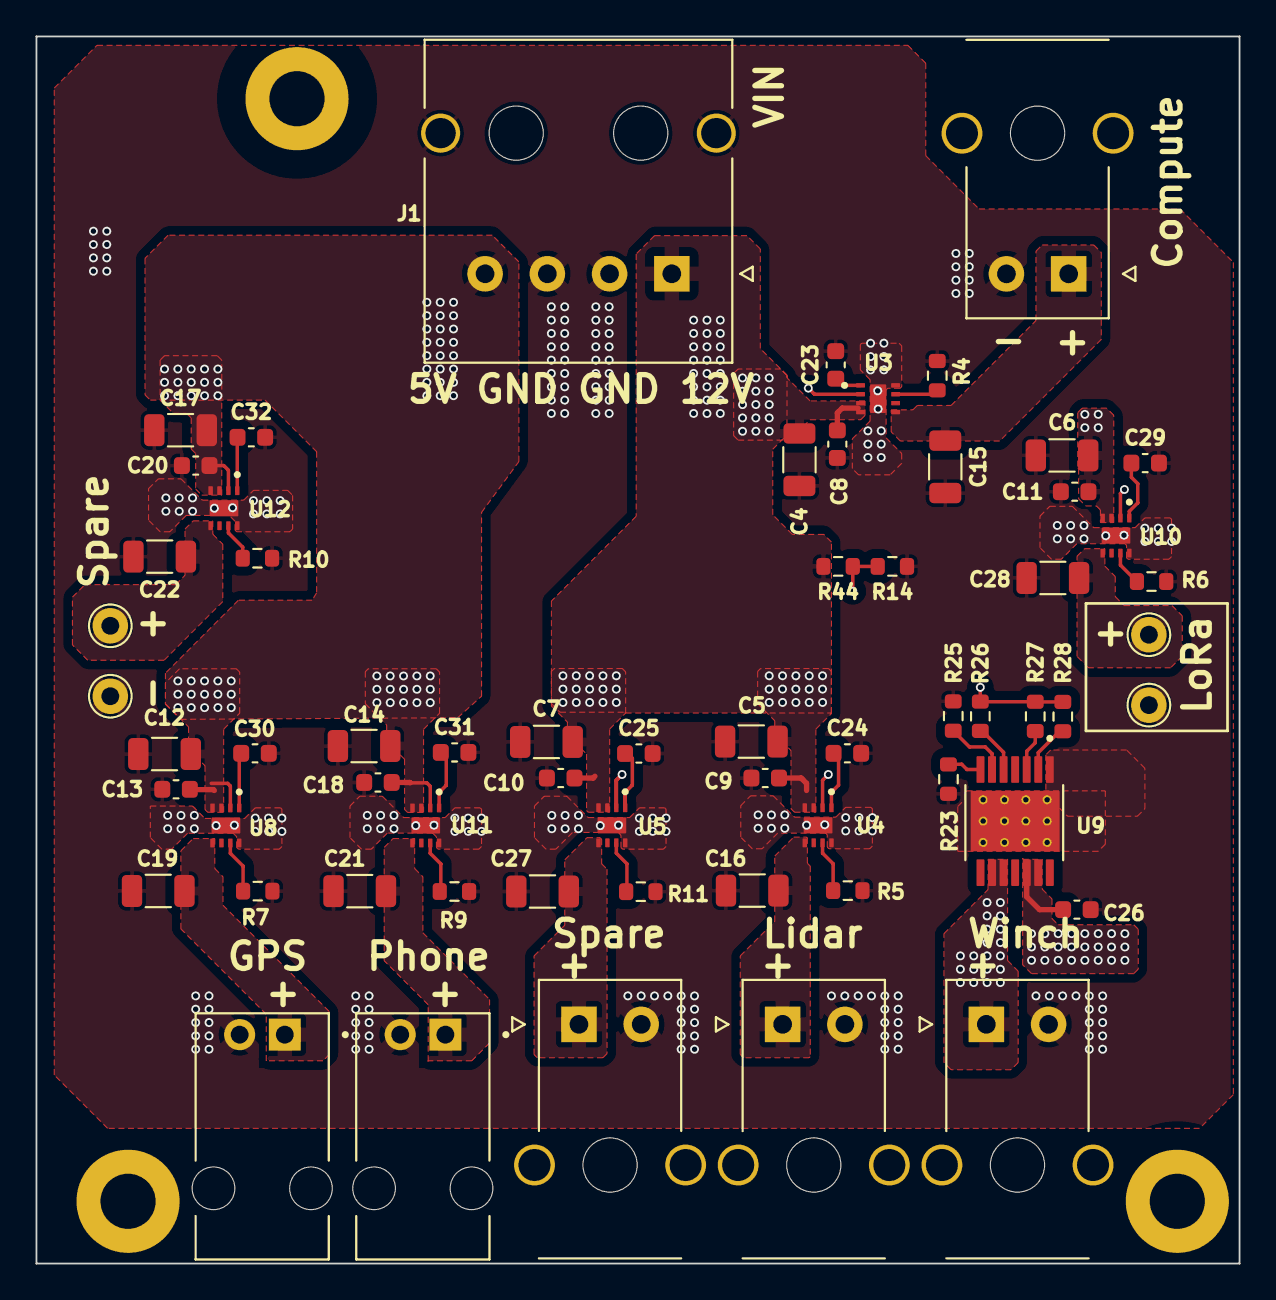
[picture p24: board Connector_Extension_Board_V1.0.kicad_pcb from above]

Board: 4 copper layers, 67.7 x 69.0 mm, 65 parts (0 on the bottom side), 31 nets.
