HuyNguyen-01/Power-Management/(commit log)

2025-12-18 Hoan thanh SCH mach Power
    [12V.kicad_sch, 5V.kicad_sch, Power_management_V2.kicad_sch]
2025-12-19 Hoan thanh SCH lan 1
    [12V.kicad_sch, 5V.kicad_sch, Connector_Extension_Board_V1.0.kicad_sch, Power_management_V2.kicad_sch]
2025-12-24 Chỉnh sủa SCH 24/12
    [12V.kicad_sch, 5V.kicad_sch, Connector_Extension_Board_V1.0.kicad_sch, Power_management_V2.kicad_sch]
2025-12-26 Hoan thanh footprint
    [12V.kicad_sch, 1723103102.stp, 5-104361-1.step, 5V.kicad_sch, 640388-3.STEP, Connector_Extension_Board_V1.0.kicad_pcb, Connector_Extension_Board_V1.0.kicad_sch, M18 Battery Terminal.step]
2025-12-29 hoan thanh sap xep
    [12V.kicad_sch, 5V.kicad_sch, CAP_C7563_TDK.step, Power_management_V2.kicad_pcb, Power_management_V2.kicad_sch]
2025-12-29 Hoan thien Sap xep Linh kien
    [12V.kicad_sch, Batterry.step, Connector_Extension_Board_V1.0.step, DIP-PUL-3005-2.step, Power_management_V2.kicad_pcb, Power_management_V2.step]
2026-01-12 Cập nhật connecter 12 5
    [12V.kicad_sch, 2165711003.stp, Connector_Extension_Board_V1.0.kicad_sch, Power_management_V2.kicad_sch]
2026-01-12 Cap nhat 12/1
    [Connector_Extension_Board_V1.0.kicad_sch]
2026-01-13 Hoan thanh chinh sua theo phan hoi 12/1
    [2157601003.step, 2165711003.stp, Connector_Extension_Board_V1.0.kicad_pcb, Connector_Extension_Board_V1.0.kicad_sch, Connector_Extension_Board_V1.0.step, Power_management_V2.kicad_pcb, Power_management_V2.step, TPS259571DSGR.step]
2026-01-20 Thay doi kich thuoc mach power
    [Power_management_V2.kicad_pcb]
2026-01-22 Layout 2201
    [12V.kicad_sch, 5V.kicad_sch, Power_management_V2.kicad_pcb, Power_management_V2.kicad_sch]
2026-01-23 Hoan thanh layout PCB Power
    [Power_management_V2.kicad_pcb, Power_management_V2.kicad_sch]
2026-01-23 Hoan thanh layout va BOM lisst
    [12V.kicad_sch, 1722871102.step, 1723103102.stp, 2157601003.step, 2165711003.stp, 5-104361-1.step, 5-104809-1.step, 5V.kicad_sch]
2026-02-03 Cap nhat chiu 3/2
    [Power_Management_V2_Checklist_And_NextSteps.xlsx, Power_management_V2.kicad_pcb]
2026-02-04 Hoan thanh chinh sua 4/2
    [2157601004.step, 2165711004.stp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]
2026-02-11 Cap nhat 11/2
    [Power_management_V2-B_Cu.gbl, Power_management_V2-B_Mask.gbs, Power_management_V2-B_Paste.gbp, Power_management_V2-B_Silkscreen.gbo, Power_management_V2-Edge_Cuts.gm1, Power_management_V2-F_Cu.gtl, Power_management_V2-F_Mask.gts, Power_management_V2-F_Paste.gtp]
2026-02-24 Cap Nhat 24/2
    [12V.kicad_sch, 5V.kicad_sch, BOM_JLCPCB_Connector_Extension_Board_V1.0.csv, BOM_JLCPCB_Power_management_V2.csv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]
2026-02-24 Tao file nen de gui
2026-02-25 Hoan thanh cap nhat ngay 25/2
    [1722861104.step, 1723103104.step, BOM_JLCPCB_Connector_Extension_Board_V1.0.csv, BOM_JLCPCB_Power_management_V2.csv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]
2026-02-26 cap nhat 26/2
    [Connector_Extension_Board_V1-B_Cu.gbl, Connector_Extension_Board_V1-B_Mask.gbs, Connector_Extension_Board_V1-B_Paste.gbp, Connector_Extension_Board_V1-B_Silkscreen.gbo, Connector_Extension_Board_V1-Edge_Cuts.gm1, Connector_Extension_Board_V1-F_Cu.gtl, Connector_Extension_Board_V1-F_Mask.gts, Connector_Extension_Board_V1-F_Paste.gtp]
